alu0100698893/Sistema-de-localizacion-para-robots/(commit log)

2017-09-03 Codigos emisores y receptores
    Codigos de los emisores y receptores a falta de algunas modificaciones
2017-09-04 Codigo receptor con ecuaciones de trilateracion modificadas
    Hemos cambiado la manera de realizar las ecuaciones de trilateracion
2017-09-05 Añadiendo ROS
    Además de realizar algunas moficaciones vamos añadir las líneas de código para ir utilizando rosserial
2017-09-07 Modificaciones para mejorar RF y errores de ultrasonido
    Hemos modificado los códigos para establecer una comunicación por RF de manera correcta y además hemos mejorado la comunicación de las interrupciones de los ultrasonidos
    [SR04_2_Emisor_A_.ino, SR04_2_Emisor_B_.ino, SR04_2_Emisor_C_.ino, SR04_2_Receptor.ino]
2017-09-09 Modificaciones para mejorar la recepcion del ultrasonido
    Hemos realizado una serie de modificaciones en lso códigos, ya que una vez mejorada la RF falta mejorar los ultrasonidos ya que se empezaron a solapar los unos a los otros
2017-09-09 Añadiendo definitivo ROS(Modificaciones)
    Añadiendo de nuevo ROS con algunas modificaciones para la publicación de mensajes.
2017-09-15 Códigos finales + memoria
    Encontramos ya los código finales mas la memoria del proyecto.
